patmtp35/offsr-24-48v/(commit log)

2026-10-25 feat: boîtier 3D du routeur (OpenSCAD, PETG)
    Claude-Session: https://claude.ai/code/session_01PESnN9L46M5HzmLQaPa7E8
    [boitier_routeur_solaire.scad]
2026-10-25 feat: dépôt offsr-24-48v — flag battery_nominal, coeff_multiplier, dossier esphome/
    - patch refait sur l'amont SeByDocKy/myESPhome 12fb7b5 (25/10/2026) : l'ancien patch ne s'appliquait plus
    (fins de ligne et offsr.h modifiés par Seby) ; renommé patches/offsr-24-48v.patch
    - nouveau flag battery_nominal (24 ou 48, défaut 48) : seuils par défaut starting/charged/discharged ;
    bornes des curseurs élargies à 20-64 V
    - apply.sh figé sur le commit amont testé (UPSTREAM_REF=main pour la dernière version)
    - nouveau dossier esphome/ : composant offsr déjà patché (identique à l'amont 12fb7b5 + patch),
    YAML v2.7 (select coeff_multiplier, substitution battery_nominal) et README expl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
2026-10-25 fix: le YAML du dépôt reprend la v2.7 réelle (substitutions, sans !secret ni chiffrement API)
    - esphome/offroutsr-24-48v-standalone.yaml remplacé par la v2.7 utilisée : tout en substitutions en tête,
    api sans chiffrement, ota sans mot de passe, victron_ble avec timeout 120 s, moyenne glissante du courant,
    PZEM complet (tension, courant, facteur de puissance, puissance)
    - coordonnées sun: remises à zéro (à renseigner) pour ne pas publier la position du site
    - README : plus de secrets.yaml, note sur l'absence de chiffrement API/OTA
    Claude-Session: https://claude.ai/code/session_01EjgCF31B1WmXYLYzKNSUL8
    [offroutsr-24-48v-standalone.yaml]
2026-10-25 Make device description dynamic based on battery nominal
    comments
2026-10-25 fix: glissières du module USB (carte 36,77 x 30,80, partie avant étroite en butée)
    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
    [boitier_routeur_solaire.scad]
2026-10-26 docs: schéma de câblage (PNG + SVG) et photos du boîtier
    Photos redimensionnées et sans métadonnées (EXIF/GPS retirés).
    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
2026-10-27 feat: écran OLED (v2.8), modèle de l'écran et dissipateur 110×75 dans les README, schéma mis à jour
    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
2026-10-27 feat: support et gabarit pour l'écran OLED 0,96 (validé à l'essai)
    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
    [boitier_routeur_solaire.scad]
2026-10-28 docs: licence MIT au nom de PFU
    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
2026-10-30 feat: rotation de l'écran OLED réglable (oled_rotation, 180° par défaut)
    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
2026-10-30 feat: trous d'inserts et passage des Dupont de l'écran OLED dans la boîte, photo du montage
    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
    [boitier_routeur_solaire.scad]
2026-11-10 docs: validation en 24 V (10/11/2026) et liste de ce qui reste à tester
    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
